suarezvictor/ESP32S3_DEV_Minimal_LowPower/Hardware/ESP32_DevBoard_Minimal_Electgpl.kicad_pcb

## KiCad design Hardware/ESP32_DevBoard_Minimal_Electgpl.kicad_pcb (2025-12-01)

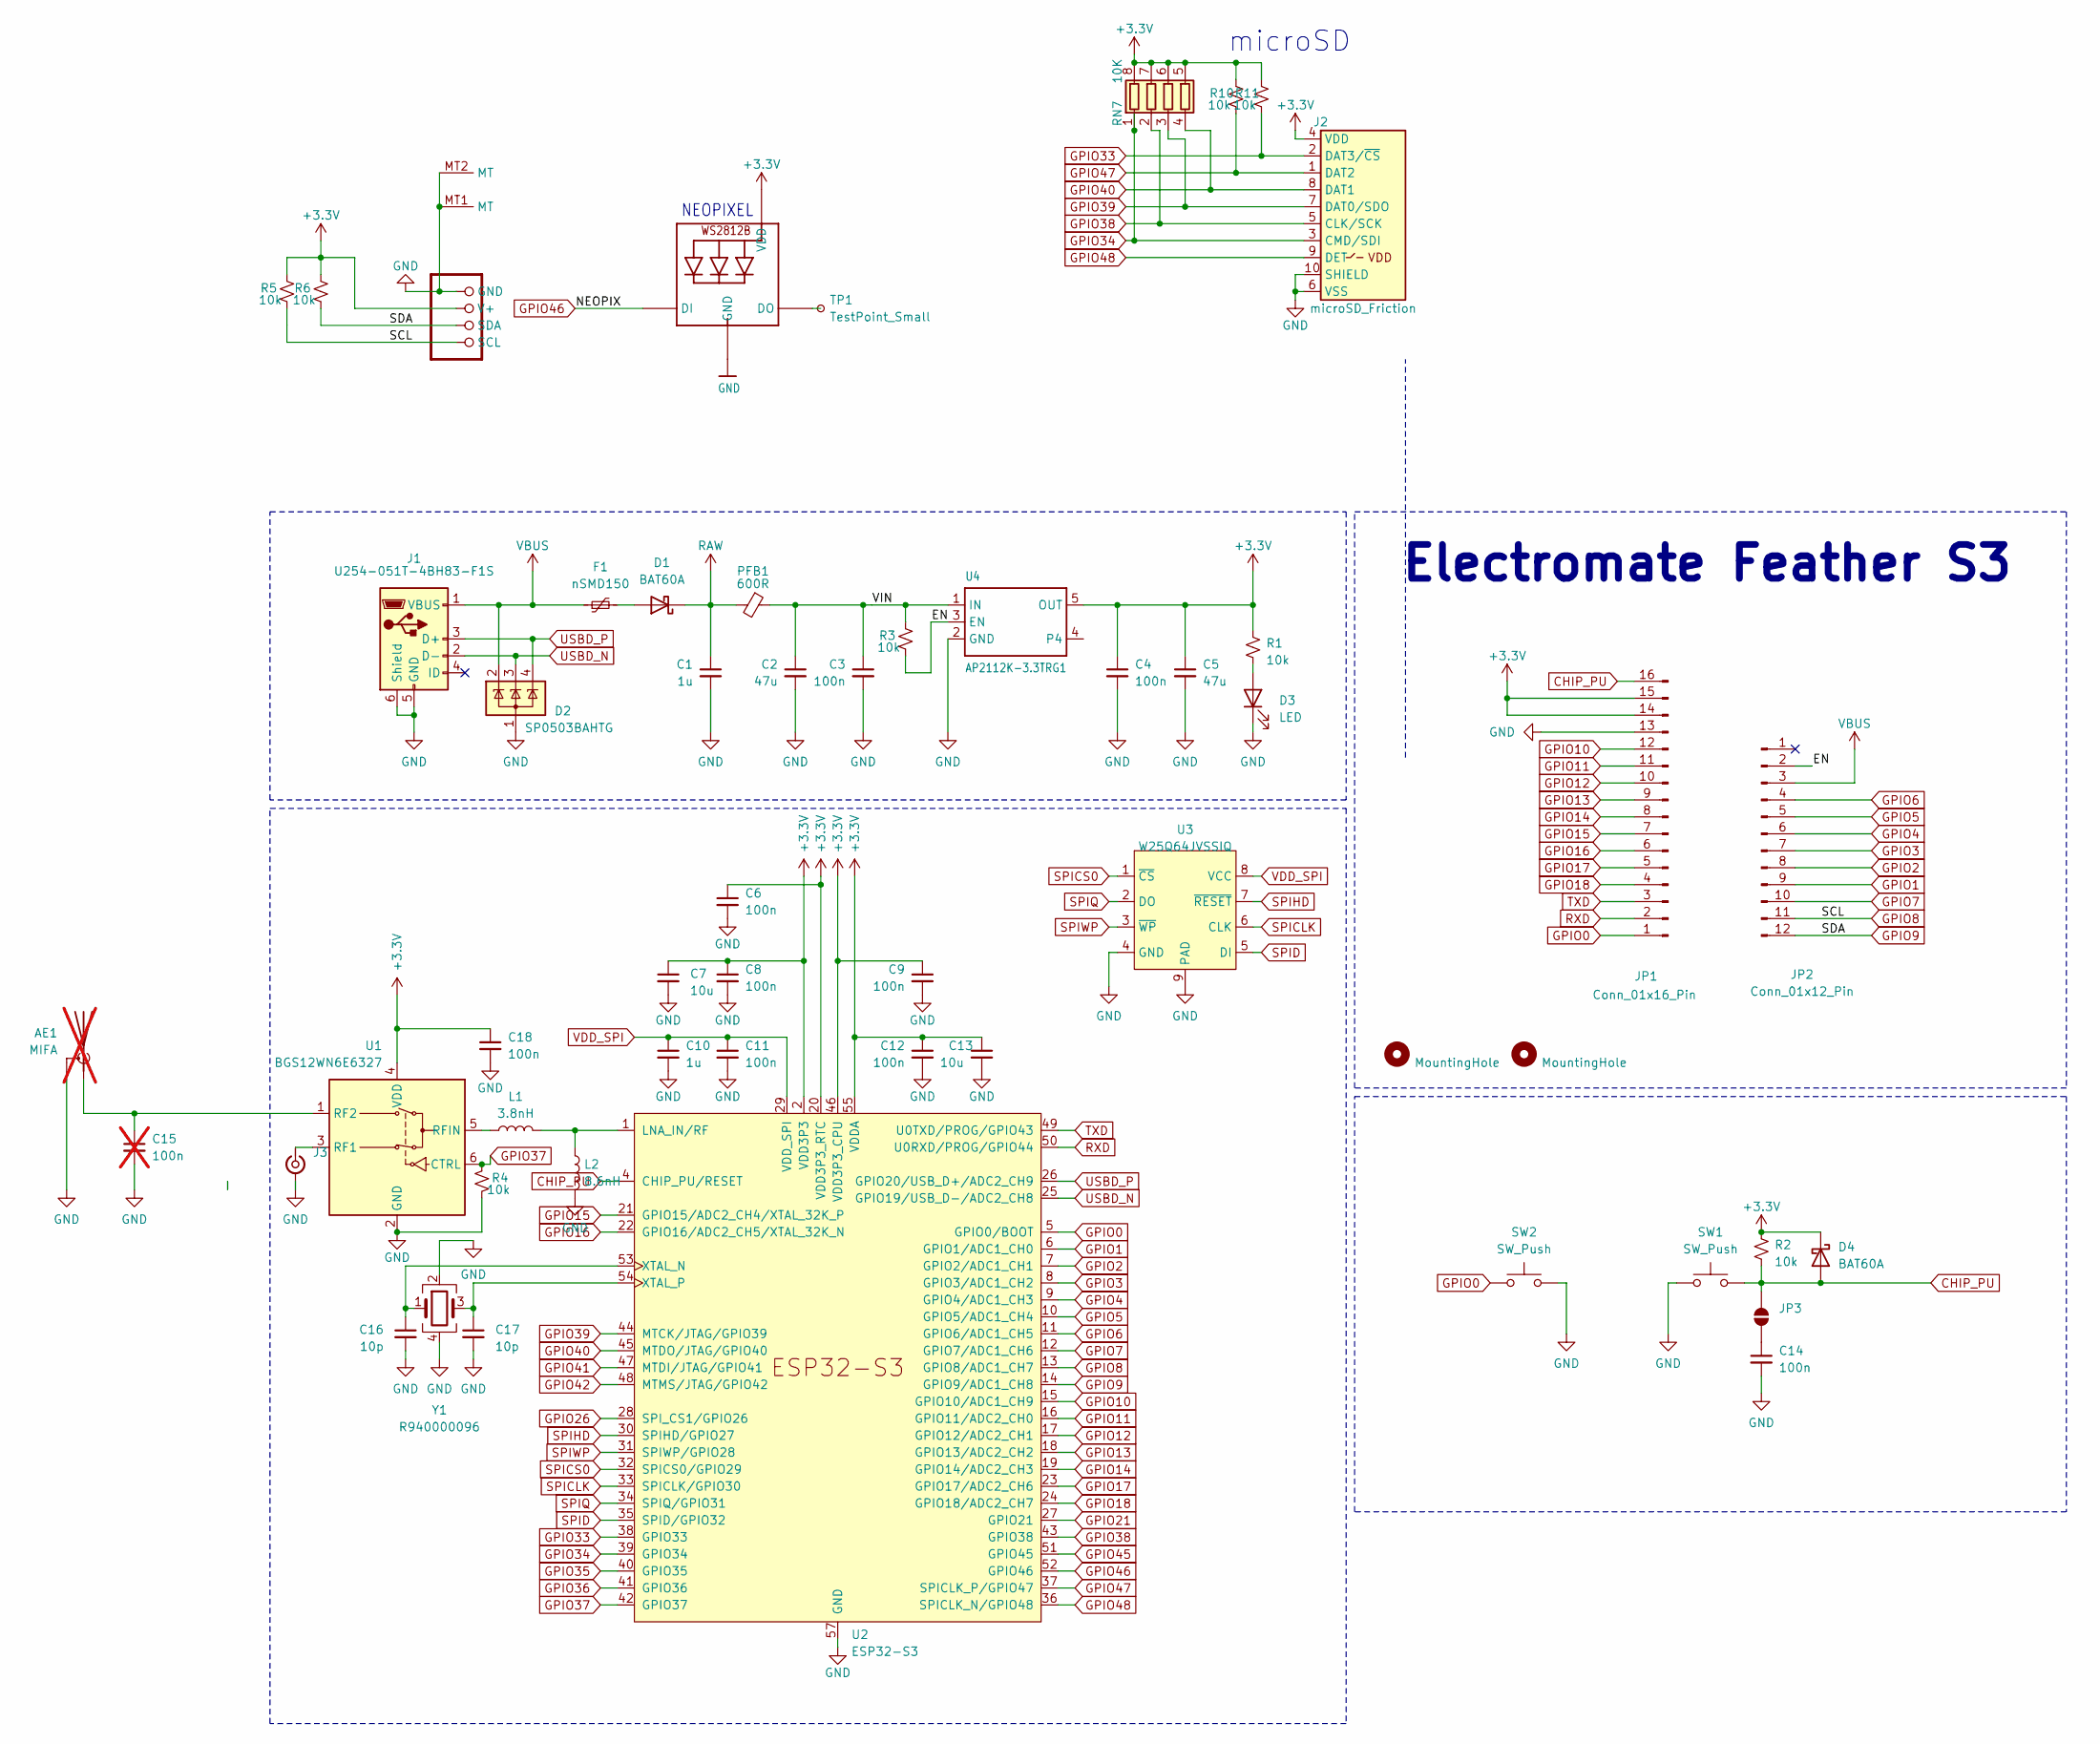
[picture p1: schematic ESP32_DevBoard_Minimal_Electgpl.kicad_sch, ESP32-S3 Dev]

Parts:
AE1: MIFA; ESPRESSIF_ESP32_MIFA_2.4GHz_Right; not fitted
C1: 1u; C_0402_1005Metric; MPN CL05X105KP5NNNC; LCSC Part Number C5673
C2: 47u; C_0603_1608Metric; MPN GRM188R60J476ME15D; LCSC Part Number C124129
C3: 100n; C_0402_1005Metric; MPN CC0402KRX7R9BB104; LCSC Part Number C1591
C4, C6, C8, C9, C11, C12, C14, C18: 100n; C_0402_1005Metric; MPN CC0402KRX7R9BB104; LCSC RE0187778
C5: 47u; C_0603_1608Metric; MPN GRM188R60J476ME15D; LCSC CA0135493
C7, C13: 10u; C_0603_1608Metric; MPN GCM188D70J106ME36D; LCSC CA0384128
C10: 1u; C_0402_1005Metric; MPN CL05X105KP5NNNC; LCSC CA0157860
C15: 100n; C_0402_1005Metric; not fitted
C16, C17: 10p; C_0402_1005Metric; MPN GRM1555C1H100GA01D; LCSC CA0137027
CONN1: QUICC; JST_SH_BM04B-SRSS-TB_1x04-1MP_P1.00mm_Vertical; MPN BM04B-SRSS-TB(LF)(SN); LCSC Part Number C160390
D1, D4: BAT60A; D_SOD-323
D2: SP0503BAHTG; SOT-143; MPN SP0503BAHTG; LCSC CP0003989
D3: LED; LED_0603_1608Metric; MPN TJ-S1608B06HQYJY-A3; LCSC PH0093820
F1: nSMD150; Fuse_1206_3216Metric_Pad1.42x1.75mm_HandSolder; MPN nSMD075-16V; LCSC CP0107097
H1, H2: MountingHole
J1: U254-051T-4BH83-F1S; USB_Micro-B_XKB_U254-051T-4BH83-F1S; MPN U254-051T-4BH83-F1S; LCSC CO0893195
J2: microSD_Friction; TF-SMD_TF-018
J3: Conn_Coaxial_Small; U.FL_Molex_MCRF_73412-0110_Vertical; MPN 734120114; LCSC Part Number C277719
JP1: Conn_01x16_Pin; PinHeader_1x16_P2.54mm_Vertical
JP2: Conn_01x12_Pin; PinHeader_1x12_P2.54mm_Vertical
JP3: SolderJumper_2_Open; SolderJumper-2_P1.3mm_Open_RoundedPad1.0x1.5mm
L1: 3.8nH; C_0402_1005Metric; MPN SCC1005C4N3SSP; LCSC IN0076375
L2: 8.6nH; C_0402_1005Metric; MPN SCW1005C8N2JST; LCSC IN0074484
LED1: WS2812B_SK6805_1515; LED-SMD_4P-L1.5-W1.5-BL; MPN SK6805-EC15
PFB1: 600R; C_0603_1608Metric; MPN BLM18SG331TN1D; LCSC WF0011783
R1, R2, R3, R4, R5, R6, R10, R11: 10k; R_0402_1005Metric; MPN RC0402JR-0710KL; LCSC RE0023874
RN7: 10K; R_Array_Convex_4x0402; MPN 4D02WGJ0103TCE
SW1, SW2: SW_Push; SW_Push_SPST_NO_Alps_SKRK; MPN SKRKAEE020; LCSC SW0049182
TP1: TestPoint_Small; TestPoint_Pad_D1.0mm
U1: BGS12WN6E6327; Infineon_PG-TSNP-6-10_0.7x1.1mm_0.7x1.1mm_P0.4mm; MPN BGS12WN6E6327XTSA1
U2: ESP32-S3; QFN-56-1EP_7x7mm_P0.4mm_EP5.6x5.6mm; MPN ESP32-S3FH4R2; LCSC Part Number C3013940
U3: W25Q64JVSSIQ; SOP-8_5.28x5.23mm_P1.27mm; MPN GD25Q64ESIG; LCSC IC0447018
U4: AP2112K-3.3TRG1; SOT-23-5; MPN AP2112K-3.3TRG1; LCSC Part Number C51118
Y1: R940000096; Crystal_SMD_2016-4Pin_2.0x1.6mm; MPN TAXM40M4ZHBCDT2T; LCSC Part Number C7206306

Connections:
+3.3V: C4.1, C5.1, C6.1, C7.1, C8.1, C9.1, C12.1, C13.1, C18.1, CONN1.2 (V+), D4.1 (K), J2.4 (VDD), JP1.14, JP1.15, LED1.2 (VDD), R1.1, R2.1, R5.1, R6.1, R10.1, R11.1, RN7.5 (R4.2), RN7.6 (R3.2), RN7.7 (R2.2), RN7.8 (R1.2), U1.4 (VDD), U2.2 (VDD3P3), U2.3 (VDD3P3), U2.20 (VDD3P3_RTC), U2.46 (VDD3P3_CPU), U2.55 (VDDA), U2.56 (VDDA), U4.5 (OUT); also elsewhere on the board
/EN: JP2.2, R3.2, U4.3 (EN)
/VIN: C2.1, C3.1, PFB1.1, R3.1, U4.1 (IN)
CHIP_PU: D4.2 (A), JP1.16, JP3.2 (B), R2.2, SW1.2, U2.4 (CHIP_PU/RESET)
GND: AE1.2 (Shield), C1.2, C2.2, C3.2, C4.2, C5.2, C6.2, C7.2, C8.2, C9.2, C10.2, C11.2, C12.2, C13.2, C14.2, C15.2, C16.2, C17.2, C18.2, CONN1.1 (GND), CONN1.MT1 (MT), CONN1.MT2 (MT), D2.1 (A), D3.1 (K), J1.5 (GND), J1.6 (Shield), J2.6 (VSS), J2.10 (SHIELD), J3.2 (Ext), JP1.13, L2.2, LED1.4 (GND), R4.2, SW1.1, SW2.1, U1.2 (GND), U2.57 (GND), U3.4 (GND), U3.9 (PAD), U4.2 (GND), Y1.2, Y1.4
GPIO0: JP1.1, SW2.2, U2.5 (GPIO0/BOOT)
GPIO1: JP2.9, U2.6 (GPIO1/ADC1_CH0)
GPIO2: JP2.8, U2.7 (GPIO2/ADC1_CH1)
GPIO3: JP2.7, U2.8 (GPIO3/ADC1_CH2)
GPIO4: JP2.6, U2.9 (GPIO4/ADC1_CH3)
GPIO5: JP2.5, U2.10 (GPIO5/ADC1_CH4)
GPIO6: JP2.4, U2.11 (GPIO6/ADC1_CH5)
GPIO7: JP2.10, U2.12 (GPIO7/ADC1_CH6)
GPIO8: CONN1.4 (SCL), JP2.11, R5.2, U2.13 (GPIO8/ADC1_CH7)
GPIO9: CONN1.3 (SDA), JP2.12, R6.2, U2.14 (GPIO9/ADC1_CH8)
GPIO10: JP1.12, U2.15 (GPIO10/ADC1_CH9)
GPIO11: JP1.11, U2.16 (GPIO11/ADC2_CH0)
GPIO12: JP1.10, U2.17 (GPIO12/ADC2_CH1)
GPIO13: JP1.9, U2.18 (GPIO13/ADC2_CH2)
GPIO14: JP1.8, U2.19 (GPIO14/ADC2_CH3)
GPIO15: JP1.7, U2.21 (GPIO15/ADC2_CH4/XTAL_32K_P)
GPIO16: JP1.6, U2.22 (GPIO16/ADC2_CH5/XTAL_32K_N)
GPIO17: JP1.5, U2.23 (GPIO17/ADC2_CH6)
GPIO18: JP1.4, U2.24 (GPIO18/ADC2_CH7)
GPIO21: U2.27 (GPIO21)
GPIO26: U2.28 (SPI_CS1/GPIO26)
GPIO33: J2.2 (DAT3/~CS), R11.2, U2.38 (GPIO33)
GPIO34: J2.3 (CMD/SDI), RN7.1 (R1.1), U2.39 (GPIO34); also elsewhere on the board
GPIO35: U2.40 (GPIO35)
GPIO36: U2.41 (GPIO36)
GPIO37: R4.1, U1.6 (CTRL), U2.42 (GPIO37)
GPIO38: J2.5 (CLK/SCK), RN7.2 (R2.1), U2.43 (GPIO38); also elsewhere on the board
GPIO39: J2.7 (DAT0/SDO), RN7.3 (R3.1), U2.44 (MTCK/JTAG/GPIO39); also elsewhere on the board
GPIO40: J2.8 (DAT1), RN7.4 (R4.1), U2.45 (MTDO/JTAG/GPIO40); also elsewhere on the board
GPIO41: U2.47 (MTDI/JTAG/GPIO41)
GPIO42: U2.48 (MTMS/JTAG/GPIO42)
GPIO45: U2.51 (GPIO45)
GPIO46: LED1.1 (DI), U2.52 (GPIO46)
GPIO47: J2.1 (DAT2), R10.2, U2.37 (SPICLK_P/GPIO47)
GPIO48: J2.9 (DET), U2.36 (SPICLK_N/GPIO48)
unnamed: AE1.1 (A), C15.1, U1.1 (RF2)
unnamed: D1.2 (A), F1.2
unnamed: D3.2 (A), R1.2
unnamed: J3.1 (In), U1.3 (RF1)
unnamed: C14.1, JP3.1 (A)
unnamed: LED1.3 (DO), TP1.1
unnamed: L1.1, U1.5 (RFIN)
unnamed: L1.2, L2.1, U2.1 (LNA_IN/RF)
unnamed: C16.1, U2.53 (XTAL_N), Y1.1
unnamed: C17.1, U2.54 (XTAL_P), Y1.3
RAW: C1.1, D1.1 (K), PFB1.2
RXD: JP1.2, U2.50 (U0RXD/PROG/GPIO44)
SPICLK: U2.33 (SPICLK/GPIO30), U3.6 (CLK)
SPICS0: U2.32 (SPICS0/GPIO29), U3.1 (~CS)
SPID: U2.35 (SPID/GPIO32), U3.5 (DI)
SPIHD: U2.30 (SPIHD/GPIO27), U3.7 (~RESET)
SPIQ: U2.34 (SPIQ/GPIO31), U3.2 (DO)
SPIWP: U2.31 (SPIWP/GPIO28), U3.3 (~WP)
TXD: JP1.3, U2.49 (U0TXD/PROG/GPIO43)
USBD_N: D2.3 (K), J1.2 (D-), U2.25 (GPIO19/USB_D-/ADC2_CH8)
USBD_P: D2.4 (K), J1.3 (D+), U2.26 (GPIO20/USB_D+/ADC2_CH9)
VBUS: D2.2 (K), F1.1, J1.1 (VBUS), JP2.3
VDD_SPI: C10.1, C11.1, U2.29 (VDD_SPI), U3.8 (VCC)

Notes on the sheet:
Electromate Feather S3
NEOPIXEL
microSD

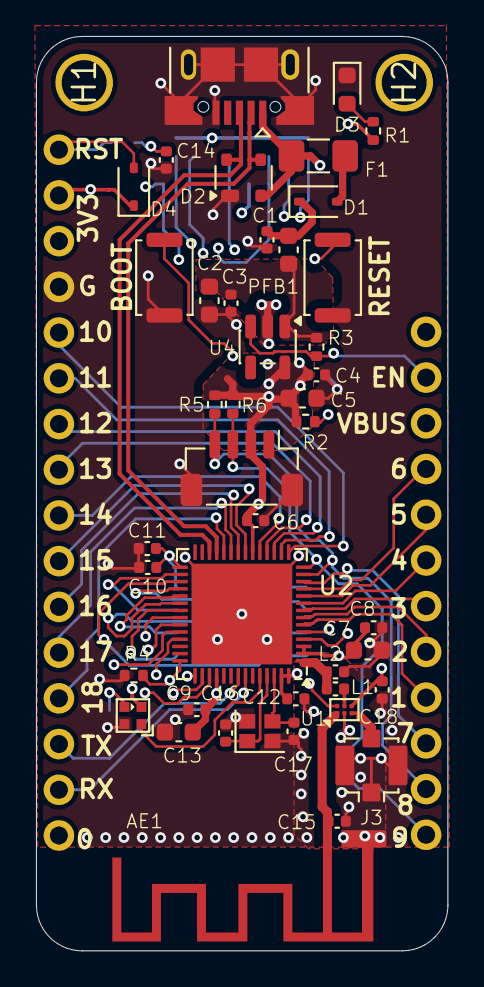
[picture p2: board ESP32_DevBoard_Minimal_Electgpl.kicad_pcb from above]

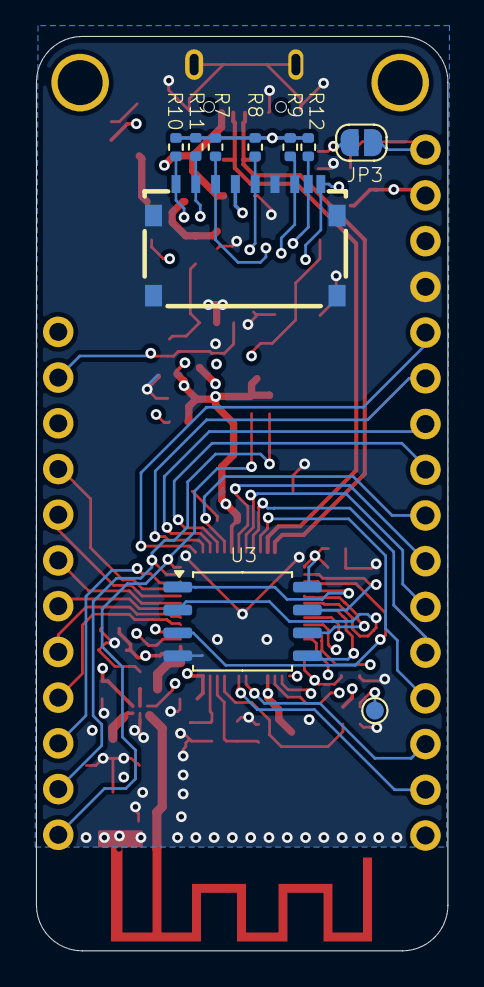
[picture p3: board ESP32_DevBoard_Minimal_Electgpl.kicad_pcb from below]

Board: 4 copper layers, 22.9 x 50.8 mm, 57 parts (12 on the bottom side), 56 nets.

Other parts of the board:
R7, R8, R9, R12: 10k; R_0402_1005Metric

Their connections:
+3.3V: R7.1, R8.1, R9.1, R12.1; also elsewhere on the board
GPIO34: R7.2; also elsewhere on the board
GPIO38: R8.2; also elsewhere on the board
GPIO39: R9.2; also elsewhere on the board
GPIO40: R12.2; also elsewhere on the board
