suarezvictor/ESP32S3_DEV_Minimal_LowPower/(commit log)

2025-11-26 feather format and DRC check
    [ESP32_DevBoard_Minimal_Electgpl.kicad_pcb, ESP32_DevBoard_Minimal_Electgpl.kicad_sch]
2025-12-01 add u.FL antenna connector
    [ESP32_DevBoard_Minimal_Electgpl.kicad_pcb, ESP32_DevBoard_Minimal_Electgpl.kicad_sch]
