suarezvictor/ESP32S3_DEV_Minimal_LowPower/(notices)

Notices in the files:
Hardware/ESP32_DevBoard_Minimal_Electgpl.kicad_sch:
Based on elecgpl, MIT license
and Adafruit Feather ESP32-S3 PCB, CC BY-SA 3.0 license
